unbleavabl/moon72/case/preview/exploded.png

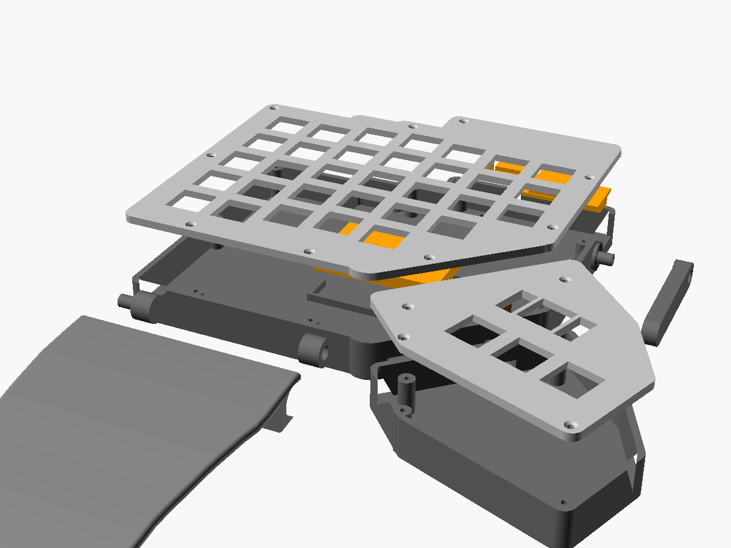
case/preview/exploded.png
