unbleavabl/moon72/case/3mf/moonlander.3mf

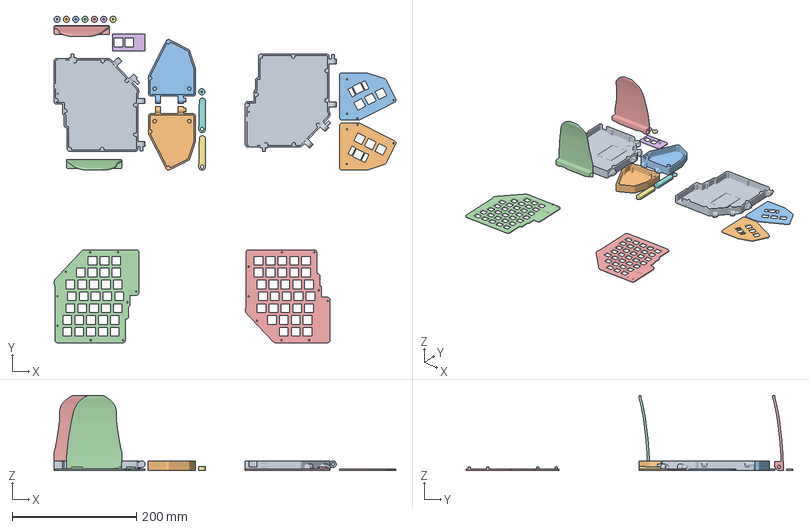
[picture p7: CAD file, 2026-10-14]
case/3mf/moonlander.3mf
549.4 x 524.6 x 121.0 mm
left tray
left thumb_tray
right thumb_tray
left palm
right palm
fit plate
leg 1
leg 2
hinge cap 1
hinge cap 2
hinge cap 3
hinge cap 4
hinge cap 5
hinge cap 6
hinge cap 7
hinge cap 8
right tray
left thumb_plate
right thumb_plate
left plate
right plate
