unbleavabl/moon72/case/stl/fit-tests/fit_plate.stl

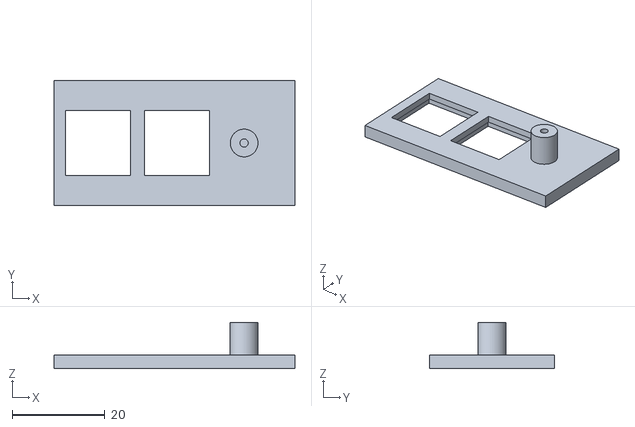
[picture p8: CAD file, 2026-10-14]
case/stl/fit-tests/fit_plate.stl
52.1 x 27.1 x 10.0
