unbleavabl/moon72/case/stl/left/thumb_tray.stl

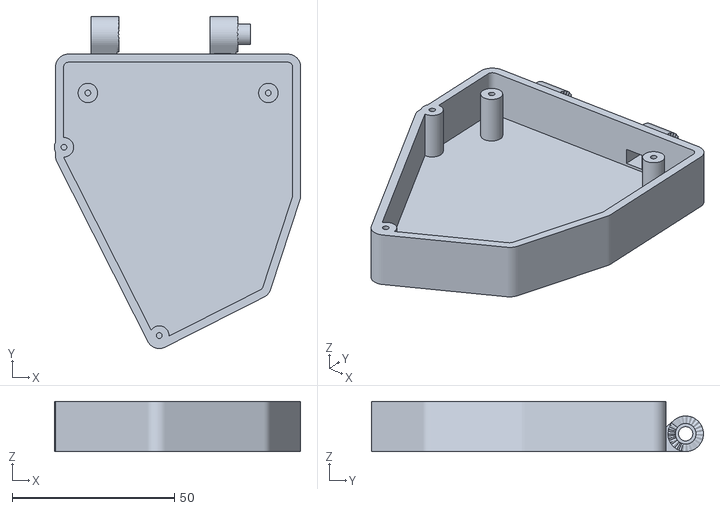
[picture p9: CAD file, 2026-10-14]
case/stl/left/thumb_tray.stl
76.1 x 102.5 x 15.5
