unbleavabl/moon72/case/stl/leg.stl

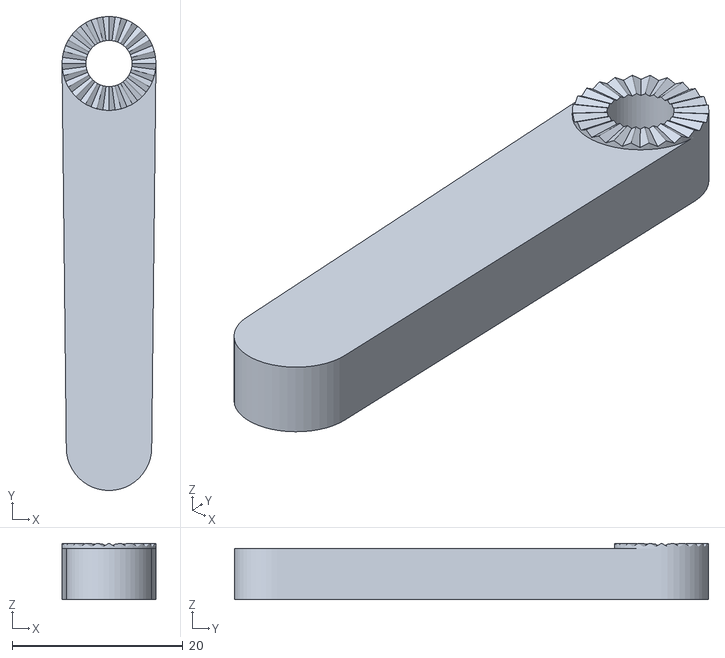
[picture p10: CAD file, 2026-10-14]
case/stl/leg.stl
11.0 x 55.5 x 6.61
