unbleavabl/moon72/case/stl/hinge_cap.stl

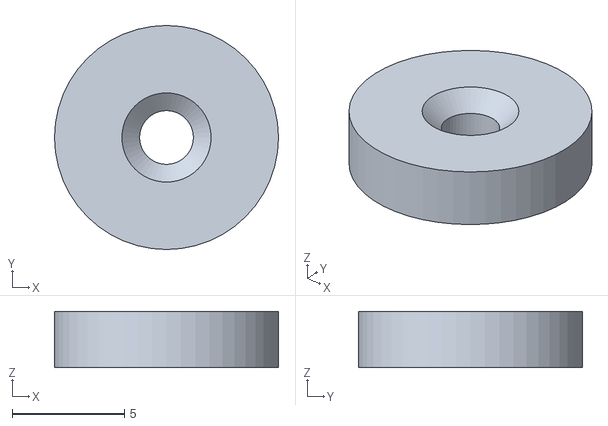
[picture p11: CAD file, 2026-10-14]
case/stl/hinge_cap.stl
10.0 x 10.0 x 2.50
