unbleavabl/moon72/case/stl/left/palm.stl

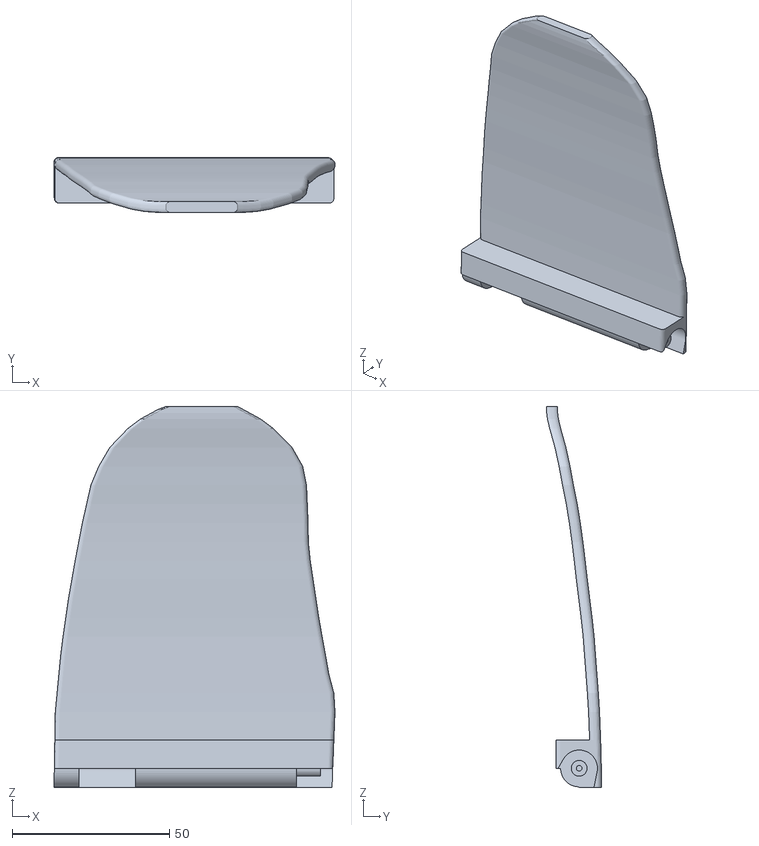
[picture p12: CAD file, 2026-10-14]
case/stl/left/palm.stl
89.2 x 17.5 x 121.0
