unbleavabl/moon72/case/stl/right/tray.stl

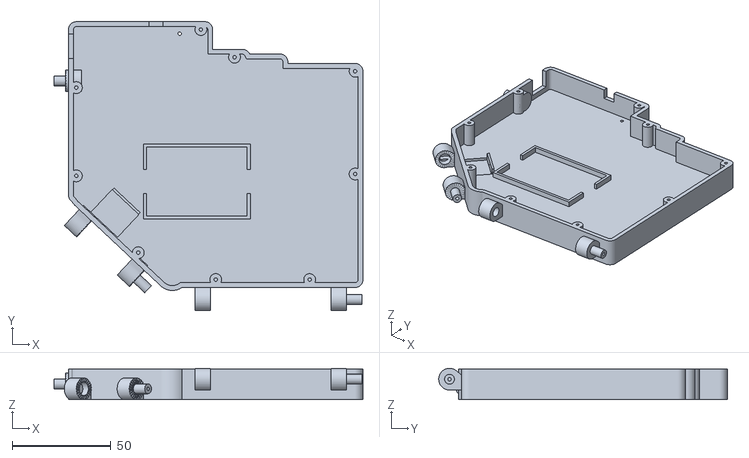
[picture p13: CAD file, 2026-10-14]
case/stl/right/tray.stl
156.7 x 146.4 x 15.9
