unbleavabl/moon72/case/stl/right/thumb_plate.stl

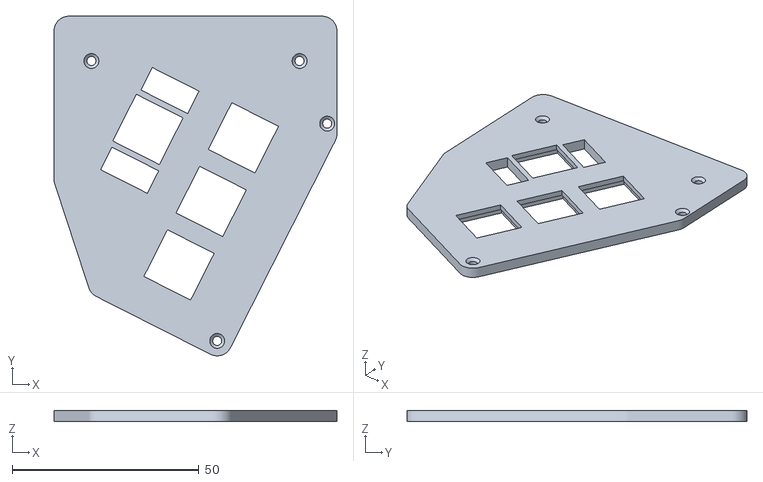
[picture p14: CAD file, 2026-10-14]
case/stl/right/thumb_plate.stl
75.7 x 90.9 x 3.00
