unbleavabl/moon72/case/stl/left/plate.stl

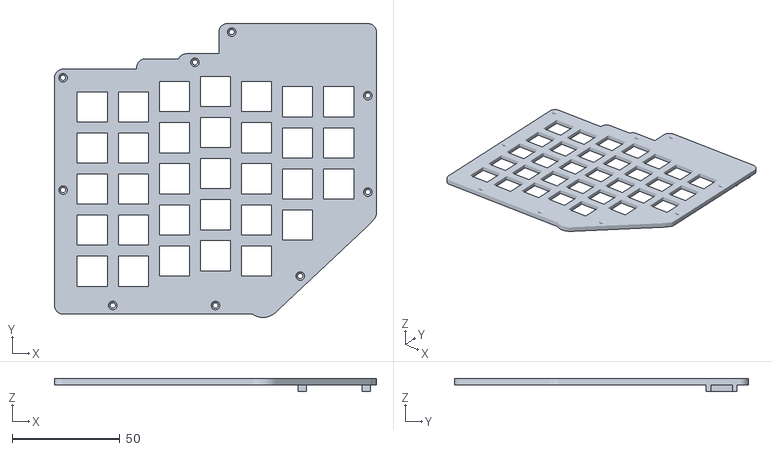
[picture p15: CAD file, 2026-10-14]
case/stl/left/plate.stl
149.3 x 136.3 x 5.95
