unbleavabl/moon72/(list of files, cad)

Other CAD files:
case/stl/right/thumb_tray.stl
case/stl/left/tray.stl
case/stl/left/thumb_plate.stl
case/stl/right/palm.stl
case/stl/right/plate.stl
