unbleavabl/moon72/wiring/wiring.html

Handwired · no PCB · wireless split

# Moon72 Wiring

72 × MX (36 per half)nice!nano v2 · ZMK6 × 7 matrix per half, col2row72 × 1N4148thumb module on a 5-pin JST XH linkLiPo 502030 · SS12D10G5 · reset

- Thick line: bare copper bus
- Thin line: insulated wire
- Sleeve where two buses cross
- 9Same number at both ends of a wire
- Rows
- Columns
- Battery + / B+
- GND
- Reset

Parts

## Bill of materials, both halves

Part | Qty | Notes | Buy
Electronics
nice!nano v2 | 2 | already have. One per half. If you ever need another: the linked board is a Pro Micro-format nRF52840 (the usual nice!nano v2 clone), but its listing doesn't say nice!nano: before soldering, check it has B+ and B− battery pads and that its pin labels match the pinout below (ZMK board nice_nano_v2) | robu.in: Promicro nRF52840 (https://robu.in/product/promicro-nrf52840-development-board/)
MX switches (3-pin or 5-pin) | 72 | 36 per half. 5-pin ones: clip the two plastic legs (plate mount) | StacksKB: switches (https://stackskb.com/product-category/switches/) Meckeys: switches (https://meckeys.com/category/accessories/keyboard-accessories/key-switches/)
1N4148 diode, through-hole (DO-35) | 72 | one per key. Not the SMD (SOD-323/SOD-123) ones | robu.in: 1N4148 DO-35 (https://robu.in/product/1n4148pf-semtech-do-35-switching-diodes-rohs/)
LiPo KP-523450 (5.2 × 34 × 50 mm), with connector | 2 | sold as 2000 mAh; a cell this size really holds ~1000 mAh. Lies on the tray floor under the keys, in a fence sized for it, 0.3 mm under the switch pins: nothing thicker fits. The listing doesn't mention a protection circuit: check for a small board under the tape at the lead end and don't use a cell without one. The connector type isn't stated (probably JST-PH 2.0): the harness end needs the mating half. Check polarity before plugging in. Your HCY-502030 also fits: set batt = [30, 20, 5] | Amazon.in: KP-523450 with connector (https://www.amazon.in/dp/B0GQSXK3YX)
SS12D10G5 slide switch | 2 | already have. In battery +; hangs under the plate's top strip, lever out of the top wall | robu.in: SS12D10G5 (https://robu.in/product/ss12d10g5-shou-han-direct-insert-2a-single-pole-double-throw-spdt-125v-3000-times-plugin-slide-switches-rohs/)
6 × 6 × 5 mm tact switch, through-hole | 2 | reset, pressed with a pin through the floor | robu.in: 6×6×5 mm tact switch (https://robu.in/product/6x6x5-tactile-push-button-switch/)
Thumb link: JST XH 2.54 mm 5-pin plug + socket, both with 300 mm 26 AWG leads | 2 pairs | one pair per half. Lies flat in a pocket in the tray floor against the hinge wall. The socket's leads are the 5 wires through the hinge tube (cut to length); the plug's leads go to the harness. One pack is 4 pieces: if that means 2 plugs + 2 sockets it's exactly enough, else get 2 | robu.in: 5-pin JST XH plug + socket with cable (4 pcs) (https://robu.in/product/5-pin-jst-xh-2-54mm-pitch-plug-and-socket-with-cable-4-pcs/)
Keys
Keycaps | 64 × 1u, 6 × 1.5u, 2 × 2u | 1.5u on the thumbs, 2u on the red keys. Or 1u everywhere: set thumb_h = 1, red_w = 1 | StacksKB: keycaps (https://stackskb.com/) Meckeys: keycaps (https://meckeys.com/category/accessories/keyboard-accessories/keycaps/)
2u plate-mount stabiliser | 2 | red keys; not needed with a 1u cap there | StacksKB: Cherry plate-mount 2u (https://stackskb.com/store/genuine-cherry-mx-plate-mount-stabilizers-2u/)
Wire and sundries
Solid copper wire, 24 AWG (0.5 mm) | ~4 m | row and column buses. Bare tinned is easiest; solid-core PVC wire with the insulation stripped off works the same | robu.in: 24 AWG solid core (strip it) (https://robu.in/product/24-awg-solid-core-insulated-wire-pvc/)
Silicone wire, 28 AWG, stranded, 2 colours | ~6 m total | harness to the nice!nano, power, reset: 27 wires per half, ~10 cm each. Two colours (rows / columns) make it much easier to trace | robu.in: 28 AWG black (https://robu.in/product/high-quality-ultra-flexible-28awg-silicone-wire-1000-m-black/) blue (https://robu.in/product/high-quality-ultra-flexible-28awg-silicone-wire-1000m-blue/) white (https://robu.in/product/high-quality-ultra-flexible-28awg-silicone-wire-1000m-white/)
Heat-shrink, 2.5 mm | ~1 m | already have. Cut into ~5 mm sleeves wherever a row bus crosses a column bus (~50 crossings) | robu.in: 2.5 mm black heat-shrink (https://robu.in/product/heat-shrink-sleeve-2-5mm-black-industrial-grade-woer-hst/)
Insulating tape (Kapton or PVC) | 1 roll | under and around the nice!nano. Not copper-foil "high temperature" tape: it conducts | robu.in: PVC insulation tape 19 mm (https://robu.in/product/electrical-insulation-multicomp-pro-pvc-tape-1920bl-pvc-polyvinyl-chloride-blue-19-mm-x-20-m/)
Hot glue | | already have. nice!nano, switch, reset button; strain relief at the hinge slots | robu.in: glue sticks (https://robu.in/product/all-purpose-hot-melt-glue-sticks-for-glue-gun-5pcs/)
Rubber feet, self-adhesive | ~8 | under the trays and the leg foot (any small bumpers)
Hardware
M2 × 8 countersunk screw | 34 | 17 per half: 9 plate to tray, 4 thumb plate to thumb tray, 1 thumb hinge, 2 wing hinge, 1 tenting leg. They cut their own thread in 1.8 mm printed pilots: no inserts, no nuts. 2 packs of 25 | robu.in: M2 × 8 CSK, 25 pcs (https://robu.in/product/easymech-ss-304-csk-countersunk-philips-head-m2-x-8-mm-bolt-25-pcs/)
Printed (case/3mf/moonlander.3mf, PLA)
plate, tray, thumb_plate, thumb_tray | 1 each per half | trays with supports (hinge bosses lie sideways)
palm (the wing) | 1 per half | prints standing on its back edge, with a brim and supports
leg (tenting arm) | 2 | same part for both halves
hinge_cap | 8 | 4 per half: 1 thumb hinge, 2 wing, 1 leg
fit_plate | 1 | print first: switch fit and M2 bite
Tools
Soldering iron, flush cutters, multimeter, glue gun
Screwdriver for your M2 heads | | already have. PH0 for the Phillips ones linked above (1.3 mm hex key for hex-socket ones) | robu.in: Stanley PH0 screwdriver (https://robu.in/product/stanley-stmt60802-8-cushion-grip-screwdriver/)

The wiring · both halves

## Main plates and thumb plates from below, to scale

Lay each half out like this while you wire: the main plate upside down with the nice!nano glued under its top strip, the thumb plate beside it where it hangs on the hinge, both back edges away from you. Row buses run across the gap above each switch row and step with the column stagger; column buses run down each column on the switch pin nearer the outer edge. Every key's other pin takes a diode to its row bus. Thin numbered wires go from the buses to the nice!nano; the thumb module's five wires run inside the inner thumb hinge, along its axis, to the connector in the tray. Tape each wire's number on at both ends.

Both halves use the same wire numbers to the same pins: each pin follows its finger, so column 0 is the outer pinky column on both. Two things don't mirror, because they are the same parts on both sides: the switch pins (on the right half the column pin is the one on the left, seen from below) and the nice!nano, whose D1–D9 header faces the keys on the left half and the back wall on the right.

Click or hover a number, part or bus. Pick one to see only its wires, in both halves. Hide finished wires Zoom in

Left half on the left, right half on the right, each seen from below: on each, the outer pinky column (column 0) is toward the middle of the drawing and the inner edge with the nice!nano's USB-C toward the outside. Thin wires that cross without a dot don't touch: they're insulated. Bare copper only crosses bare copper under a sleeve (grey block). Dots are solder joints. The battery is drawn dashed: it lies in the tray, not on the plate; its JST-PH plug sits beside it.

Harness

## The 27 wires in each half

One row per wire, in number order; the same table serves both halves. Hover a row to see that wire in the drawing (a zoomable copy sits beside the table); click it to keep it picked. Tick each one off once both ends are soldered. Ticks are kept in this browser.

Clear ticks

Wire | From | To | Done
Plate to nice!nano
1 | Row 0 bus, inner end | D4
2 | Row 1 bus, inner end | D5
3 | Row 2 bus, inner end | D6
4 | Row 3 bus, inner end | D7
5 | Row 4 bus, inner end | D8
6 | Connector pin 1 (tray-side half) | D9
7 | Column 0 bus (pinky outer), top end | D21
8 | Column 1 bus (pinky), top end | D20
9 | Column 2 bus (ring), top end | D19
10 | Column 3 bus (middle), top end | D18
11 | Column 4 bus (index), top end | D15
12 | Column 5 bus (index inner), top end | D14
13 | Column 6 bus (innermost), top end | D1
Thumb link, tray side (tray-side half of the JST XH pair)
14 | Connector pin 2 (tray-side half) | Column 3 bus, bottom end
15 | Connector pin 3 (tray-side half) | Column 4 bus, bottom end
16 | Connector pin 4 (tray-side half) | Column 5 bus, bottom end
17 | Connector pin 5 (tray-side half) | Column 6 bus, bottom end
Thumb link, module side (module-side half's leads)
18 | Row 5 bus, innermost thumb end | Connector pin 1 (module-side half)
19 | App key, column pin | Connector pin 2 (module-side half)
20 | Space key, column pin | Connector pin 3 (module-side half)
21 | Bksp key, column pin | Connector pin 4 (module-side half)
22 | Gui key, column pin | Connector pin 5 (module-side half)
Power and reset
23 | Battery JST-PH pigtail, red | Power switch, middle pin
24 | Power switch, outer pin | B+
25 | Battery JST-PH pigtail, black | GND (D1-D9 header)
26 | Reset button, leg 1 | RST
27 | Reset button, leg 2 | GND (B+ header)

+−Fit

How each part connects

## Buses, keys, thumb link, power

### Switches

Clip every switch in the same way round: pins toward the back edge, LED window toward you (on the thumb plate, "back" is toward the hinge). Then the pin nearer the outer edge of the half takes the column bus and the other one the diode. On the thumb module that rule follows each key's own turn.

### Buses

Bare solid copper, soldered at every joint. Columns: straight down each column over the column pins. Rows: across the gap above each switch row, stepping up or down at each column edge with the stagger. Rows 3 and 4 are shorter (6 and 5 keys). Slide sleeve or heat-shrink over the column bus wherever a row crosses it: bare copper on bare copper shorts.

### Keys

The diode's plain end on the switch's free pin, its black band end on the row bus. Clip the legs short once both ends are soldered.

### Thumb link

Row 5 is the thumb module's own bus. Its five wires (18–22) are the leads of the module-side half of a JST XH pair. They run inside the inner thumb hinge: out of the thumb tray through a slot in its knuckle, along the hollow tube on the hinge axis, and out through a slot in the tray's knuckle into the other half, which lies flat in a pocket in the tray floor. On the axis they only twist when the module tilts: no loop, nothing shows. The tray-side half's leads join row 5 to D9 (wire 6) and the four key columns to the bottom ends of column buses 3–6 (14–17). Wires 18–22 are the connector's own 26 AWG leads: five of them pass the 4.4 mm tube (bundled 3 + 2 through the slots).

### Power

Battery red, via its JST-PH pigtail, to the switch's middle pin; the switch's outer pin to B+. Battery black to GND. Off is the switch's other position: the battery only charges over USB with the switch on. Reset: two diagonal legs of the 6×6 button to RST and GND.

### nice!nano

Glued under the plate's top strip between its two blocks, component side away from the plate (toward you while wiring), USB-C into the inner wall's notch. Solder the wires from the component side; the 3 mm under the board is for the pin stubs. D10 and D16 are NFC pins: leave them.

Every diode in these drawings is drawn like this: red body, black band. The black band always faces the row bus.

Pin reference

## nice!nano pins, each half

The boards as they lie while you wire, turned so USB-C is up. They are the same board, so the right half's is not a mirror image: its D1–D9 header ends up on the other side.

21 pins used per half: rows 0–5 on D4–D9, columns (pinky outer to innermost) on D21, D20, D19, D18, D15, D14, D1, B+, RST and two GND. Free: D0, D2, D3 (I2C pair, for a display later). Check the pin names printed on your board against this before soldering.

Build order

## Wiring checklist

0 of 11 done Clear ticks

1. PlateSwitches clipped into both plates, all with the pins toward the back (LED window toward you); 2u stabiliser on the red key
2. BusesColumn buses: bare copper down each column on the pin nearer the outer edge (right one from below on the left half), switch pins soldered on
3. BusesRow buses 0-4: bare copper across, in the gap above each switch row, stepping with the stagger; sleeve every column crossing
4. KeysA diode from each switch's other pin to its row bus, black band at the bus (64 on the main plates)
5. ThumbsThumb plates: diodes, then the row 5 bus from the innermost thumb to the red key
6. ThumbsModule-side half of the JST XH pair (wires 18-22): leave its leads loose for now. They run inside the inner thumb hinge and get soldered to the thumb plate (pin 1 to row 5, pins 2-5 to the red key and the thumbs' column pins) after the module is on: see Assembly
7. nice!nanonice!nano hot-glued component side up between its two blocks, USB-C at the inner edge; Kapton under it
8. HarnessWires 1-13: rows and columns to the nice!nano (harness table)
9. HarnessWires 14-17 and 6: tray-side half of the JST XH pair, leads to the bottom of columns 3-6 and to D9
10. PowerPower switch and reset button glued in the top strip; wires 23-27; battery JST-PH pigtail
11. TestMeter tests below, both halves, before the plates go on

Putting it together

## Assembly

The thumb module and the wing both go on by sliding along their hinge axis from the outer side, onto both of their bosses at once; every screw is then on an outside end. Pictures are the model's renders (case/preview).

### 1Before you print

1. Print case/layout_left.svg at 100 % (mirror it for the right hand), rest your hands on it and check the thumb reach. Tune thumb_rot, thumb_s0, thumb_off, hinge_drop in moonlander.scad and re-run case/build.sh.
2. Print fit_plate on its own: switches must click in firmly (else switch_cut) and an M2 must bite in the pilot (else pilot_d).
3. Print the rest from case/3mf/moonlander.3mf (every part already in its print orientation).

### 2Wire the plates

1. Switches into both plates, all pins toward the back edge; the 2u stabiliser on the red key.
2. Follow the drawing above and the checklist below: buses, diodes, then wires 1-17 and 23-27 per half.
3. Tray-side half of the thumb link (JST XH) on the main harness (wires 6, 14-17). The module-side half's leads stay loose at the thumb end: they go through the hinge first.
4. nice!nano hot-glued between its blocks under the top strip, USB-C toward the inner edge.
5. Flash, then do the meter tests at the bottom of this page.

### 3Thumb wires through the hinge

1. Plates off. Plug the two halves of the JST XH pair together and lay the pair flat in its pocket in the tray floor, against the hinge wall.
2. Push the module-side half's 5 leads (cut to length, ends bared) out through the slot in the tray's inner hinge knuckle, so they come out of the knuckle's bore. The plug stays in the tray: it can't pass the tube.
3. Thread them into the end of the thumb tray's tube, along it, and out through the slot in its knuckle into the thumb tray.



### 4Thumb module on

1. Hold the thumb tray level with the tray, off to the outer side along the hinge, and slide it in along the hinge, taking up the leads' slack. Its outer knuckle goes onto the tray's boss and its tube into the tray's inner knuckle, both at once.
2. Push until the teeth mesh at the angle you want (0, 15, 30 or 45°). One cap on the outer end, 1 × M2 into the boss. This one screw clamps both hinge units.
3. Solder the 5 leads to the thumb plate: pin 1 to row 5, pins 2-5 to the red key and the thumbs' column pins (wires 18-22). Tilt through the full range once: the leads only twist.
4. Thumb plate onto the thumb tray, 4 × M2.

### 5Close the main half

1. Battery in its fence, JST-PH plugged in, switch off.
2. Plate into the tray (the USB-C, switch and reset notches are open at the top), 9 × M2.

### 6Wing and leg

1. Wing: hold it in front of the tray, off to the outer side, and slide it in along the front edge. Its outer knuckle goes onto the tray's boss and its own boss into the tray's inner lug. A cap on each end, 1 × M2 each. Tighten until it swings stiffly but still drops under its own weight.
2. Leg: arm onto the boss on the inner wall, teeth meshed, stowed (pointing forward along the wall). Cap, 1 × M2.



### 7Using it

1. Thumb angle: loosen the thumb hinge's one M2 about two turns, slide the module ~1 mm outward so the teeth come apart, tilt it a step, push back, tighten.
2. Tenting: loosen the leg's M2, pull the arm out so its teeth come apart, swing it down and tighten. Then tilt the thumb module down until it rests on the desk. Leg 15° / 30° / 45° / 60° / 75° / 90° gives about 3° / 7° / 11° / 13° / 15° / 15° of tent; at 90° the thumb module rests on its 30° step.
3. The wing swings freely: it lies on the desk flat, and tents with the board.
4. To take the thumb module off: plate off, unplug the JST XH pair, take out the thumb hinge screw and slide it out toward the outer side; the leads come with it through the tube.



Before the plates go on

## Test with a meter, battery unplugged

1. Beep setting, probes on B+ and GND: it must not beep. Same for 3V3 and GND.
2. Diode setting, red probe on the column pin, black on the row pin: for the Q key (row 1, column 1) that is D20 and D5. Press: about 0.5–0.7 V. Release: nothing. Repeat for all 36 keys of the half, thumbs through the mated connector.
3. A reading with the key released means that row and column touch somewhere. Nothing when pressed usually means a diode is in backwards, or a sleeve is missing nowhere near where you're looking.
4. Rows against columns, beep setting, nothing pressed: no pair may beep.
5. Switch: with the battery plugged in, measure B+ to GND: about 3.7–4.2 V in the on position, 0 V in the off position.
6. Then flash and type every key (a key tester page or wev).
